j-passmore/mech5720-2026-Dynamic-Aperture-Using-LCD/assets/banner/banner.pdf

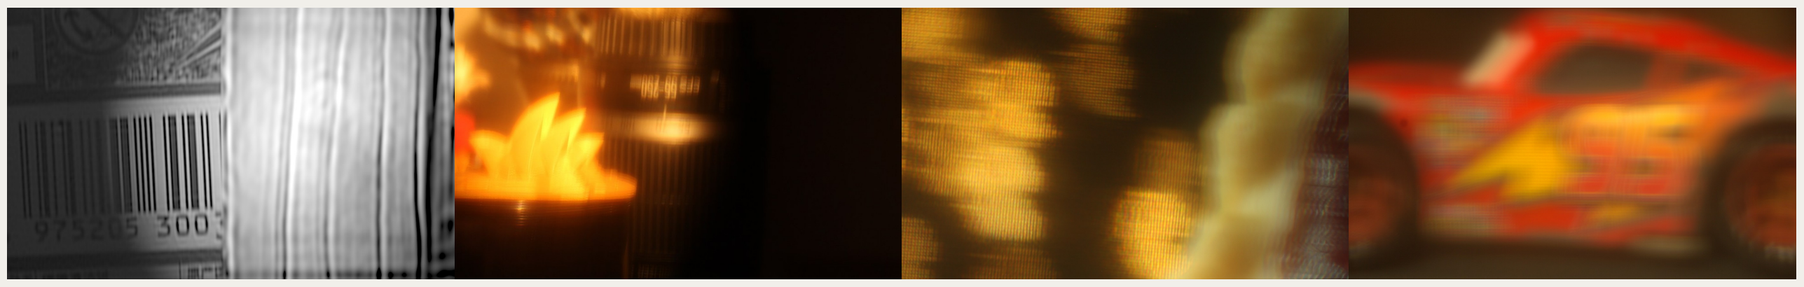
[picture p47: figure]

MAJOR PROJECT | GROUP 08 | MECH5720

# DYNAMIC APERTURE

U S I N G T R A N S M I S S I V E L I Q U I D C R Y S T A L D I S P L A Y C O N T R O L
