j-passmore/mech5720-2026-Dynamic-Aperture-Using-LCD/App/Capturing/Windows-System/coded_apertures/depth_2_33x33_preview.png

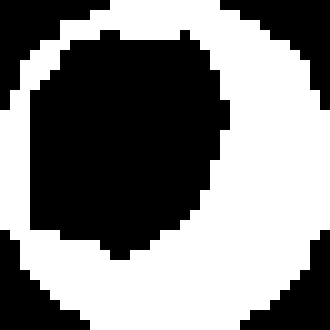
App/Capturing/Windows-System/coded_apertures/depth_2_33x33_preview.png
