j-passmore/mech5720-2026-Dynamic-Aperture-Using-LCD/Out/Depth_Estimation/pixel_by_pixel_method/depth_map.png

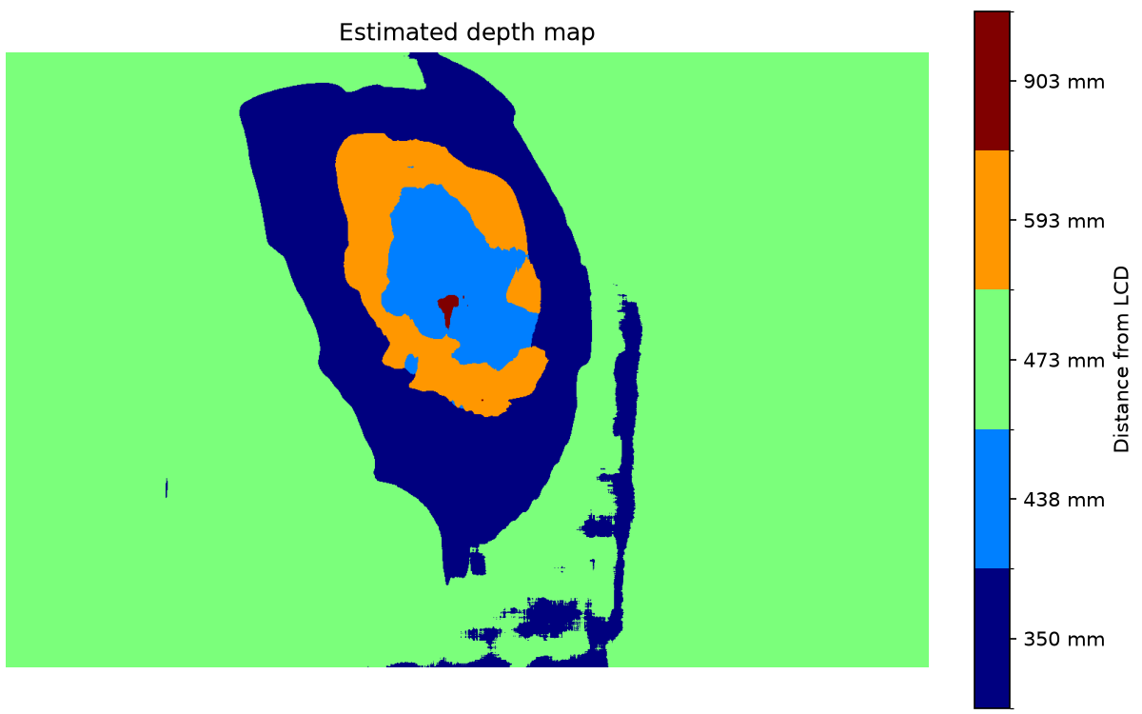
Out/Depth_Estimation/pixel_by_pixel_method/depth_map.png
