j-passmore/mech5720-2026-Dynamic-Aperture-Using-LCD/Out/Custom_Bokeh/ncc/bokeh_results.png

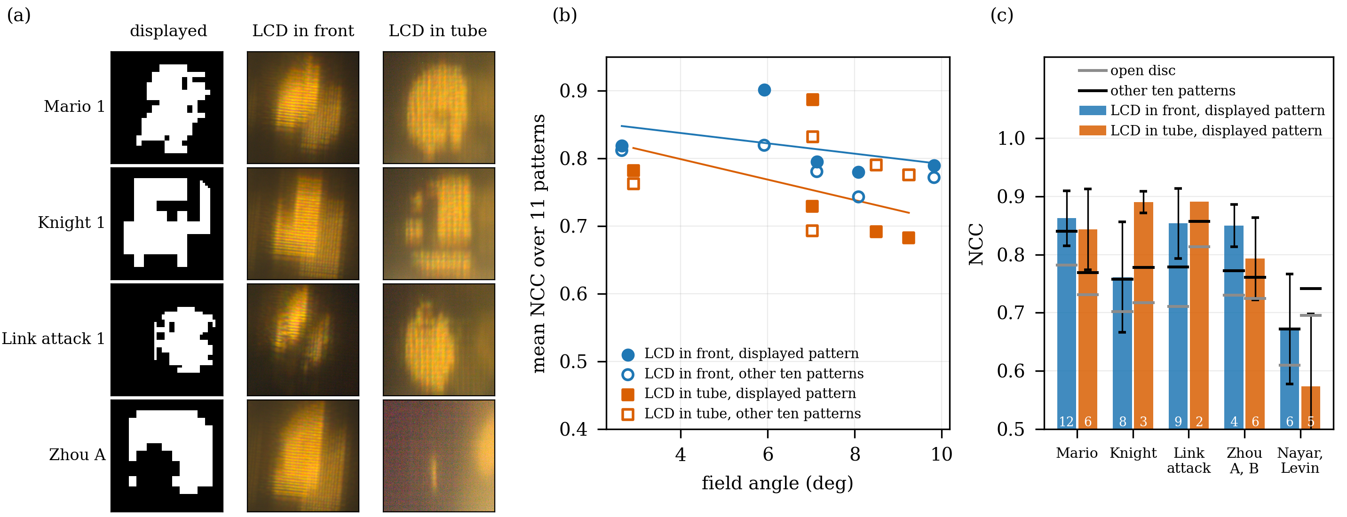
Out/Custom_Bokeh/ncc/bokeh_results.png
