j-passmore/mech5720-2026-Dynamic-Aperture-Using-LCD/Captures/Depth_Estimation_and_Reconstruction/distances.yaml

Distances are measured from LCD in front of lens to the object.
Camera is at 35mm zoom, canon EOS60D, 5.0 aperture, 2s shutter speed and iso 200. 
psf1 = 350mm
psf2 = 438mm
psf3 = 473mm
psf4 = 593mm
psf5 = 903mm
