j-passmore/mech5720-2026-Dynamic-Aperture-Using-LCD/(commit log)

2026-11-02 Made framework
2026-11-02 Add the flutter shutter: the Ubuntu capture app and the deblur and score scripts
    App/Capturing/Ubuntu-System holds the capture app from ethandoddo/MECH5720_MajorProject:
    server.py, camview_capture.py, capture_series.py and the modules they import, the masks,
    the Arduino sketch, setup_laptop.sh and requirements.txt. It includes the panel Offset
    arrows. The Experiments window drops the Bokeh tab; the image and GIF tools in Controls
    stay. The README follows: no Bokeh or Gates sections, and the flutter scoring moves to
    the processing README.
    App/Processing/IV-Flutter_Shutter holds flutter_deblur.py, flutter_score.py, rawframe.py
    and the "95" template, with a README, requirements.txt and .gitign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
2026-11-02 One root README, the key flutter figure and its photos
    The root README is now the build guide the brief asks for. It opens with the unit code, year
    and title. The whole rig comes first: the parts, the build, the laptop and camera setup and the
    capture app. Each experiment then has its own section. The two folder READMEs fold into it. Every
    sentence follows the group's writing rules.
    flutter_figure.py redraws the report's flutter figure from the photos in data/. That folder holds
    the reference and coded CR2 of Run2_f5_6, Run19 and Run2_f22, 114 MB in all. The script deblurs
    with 40 Richardson-Lucy iterations at the blur lengths flutter_score.py found. Its MSEs match the
    saved scores: 0.00285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
2026-11-04 Raw captures, the Out folder layout and the README as the build guide
    Captures/ holds the raw photos per experiment: the reference and coded CR2 of the six flutter
    runs with their traces, and the 23 bokeh CR2s with the panel in front of the lens and inside the
    tube. Out/ holds what the scripts write. Its figures and GIFs stay out of git, so rerun the
    scripts to make them.
    bokeh_figure.py draws the bokeh figures and GIFs from the raw photos and measures the panel's
    pixel grid in every highlight. flutter_figure.py reads Captures/Flutter_Shutter and draws the
    inside-tube figure as well as the front one. Its MSEs match the saved RL40 scores. The sprites
    join the capture app.
    The root README is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
    [highlights.csv]
2026-11-07 Turn the bokeh crops to face the same way as the pattern and call the inside position behind the lens
2026-11-07 Depth estimation and reconstruction with one shared copy of Emma's code
    Emma's pixel by pixel method sits beside Jayden's vertical strip method in
    I-Depth_Estimation and II-Post_Capture_Reconstruction. common.py, dfd.py,
    calibrate.py and psf_fourier.py live once at the top of I-Depth_Estimation and
    all four scripts import them. Every script reads Captures/Depth_Estimation and
    writes to Out/<experiment>/<method>/. Each reconstruction script runs its depth
    script when the depth map is missing.
    Emma's capture tools move into App/Capturing/Windows-System.
    [capture_photo.py, check_saturation.py, distances.yaml]
2026-11-07 One captures folder for depth estimation and reconstruction
    Both experiments read the same dark frames, PSFs and scene pairs, so the
    photos live once in Captures/Depth_Estimation_and_Reconstruction. The empty
    Captures/Post_Capture_Reconstruction folder goes. Out/ keeps one folder per
    experiment.
2026-11-07 Add the depth scene pair
    mask1.CR2 and mask2.CR2 are the raw photos behind the report's depth
    results, shot on 25 October at 2 s, ISO 200 and f/5. They sit at
    Scale_1/, where the pixel by pixel method looks by default. The dark
    frames and PSF photos are still to come.
2026-11-07 Bring back Emma's 2x2 depth figure and save each panel on its own
    The pixel by pixel depth script draws the capture, the depth map, the
    confident pixels and the all-in-focus image again, as Emma's original did.
    It also saves the mask 1 photo and both depth maps as separate images.
    Git tracks the 2x2 figure and the depth map once a real calibration draws
    them.
2026-11-07 Show the pixel by pixel depth figure under depth estimation
    depth_heatmap.png is Emma's 2x2 figure from her real calibration on the
    Scale_1 scene pair, cropped without its title. estimate_depth.py writes a
    full size copy to the same path once the dark frames and PSFs are in.
2026-11-07 Add the depth calibration photos
    Ten dark frames, both PSF sets, ten ambient frames and a black level frame,
    all at 2 s, ISO 200 and f/5. The report used Scale_1/psfs_v2. Every photo
    in the first set Scale_1/psfs clips.
2026-11-07 Reproduce the depth and reconstruction figures from the README commands
    calibrate.py reads Scale_1/psfs_v2 by default and the README runs it with
    --allow-saturated, as the report run did. The README commands then redraw
    the report's psf_pairs.png, psf_fourier.png and all_in_focus.png pixel for
    pixel. The README shows the depth figure and the before and after
    reconstruction of the mask 1 photo that those commands write to Out/.
    The barcode comparison goes, since no README command redraws it.
2026-11-08 Fix: leave the third Mario frame out of the front-of-lens bokeh GIF after the camera moved
2026-11-08 Feature: add the bokeh NCC scoring scripts that give the report's numbers
    [bokeh_ncc_table.csv]
2026-11-08 Docs: add the report PDF, say what the flutter table needs and fix the psf4 key
    [distances.yaml]
2026-11-08 Docs: add the title banner, credit the sprites to their games and name the raspberry pie
