j-passmore/mech5720-2026-Dynamic-Aperture-Using-LCD/(notices)

Notices in the files:
README.md:
Licence: MIT
