j-passmore/mech5720-2026-Dynamic-Aperture-Using-LCD/Hardware-Modifications/images/02_lifting_cell_off_backlight.jpeg

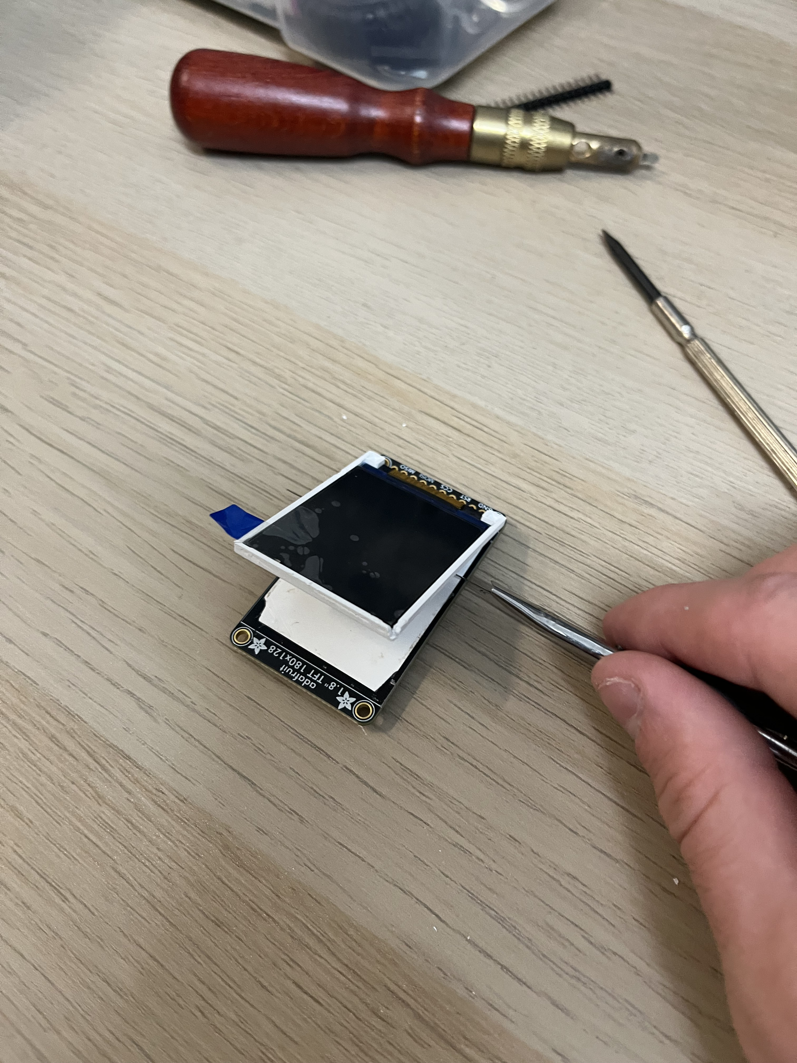
[picture p9: Hardware-Modifications/images/02_lifting_cell_off_backlight.jpeg]
Hardware-Modifications/images/02_lifting_cell_off_backlight.jpeg
