j-passmore/mech5720-2026-Dynamic-Aperture-Using-LCD/Hardware-Modifications/images/03_separated_cell.jpeg

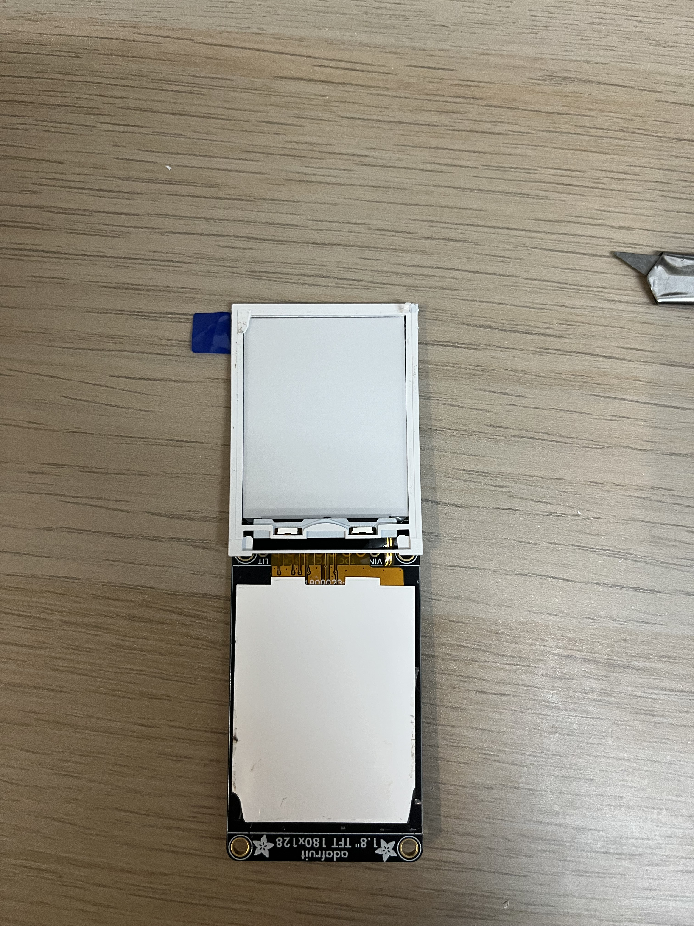
[picture p10: Hardware-Modifications/images/03_separated_cell.jpeg]
Hardware-Modifications/images/03_separated_cell.jpeg
