j-passmore/mech5720-2026-Dynamic-Aperture-Using-LCD/Hardware-Modifications/images/04_removing_reflector_and_diffuser.jpeg

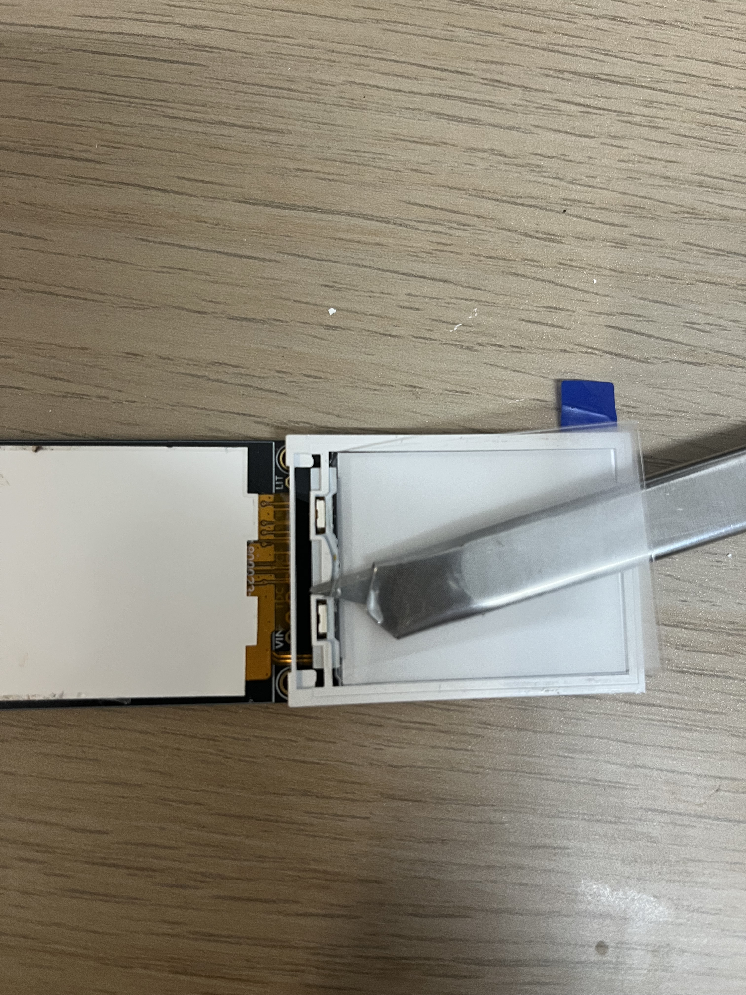
[picture p11: Hardware-Modifications/images/04_removing_reflector_and_diffuser.jpeg]
Hardware-Modifications/images/04_removing_reflector_and_diffuser.jpeg
